Sirawit7205/dual-fan-control/dual_fan_control.kicad_pcb

## KiCad design dual_fan_control.kicad_pcb (2023-08-16)

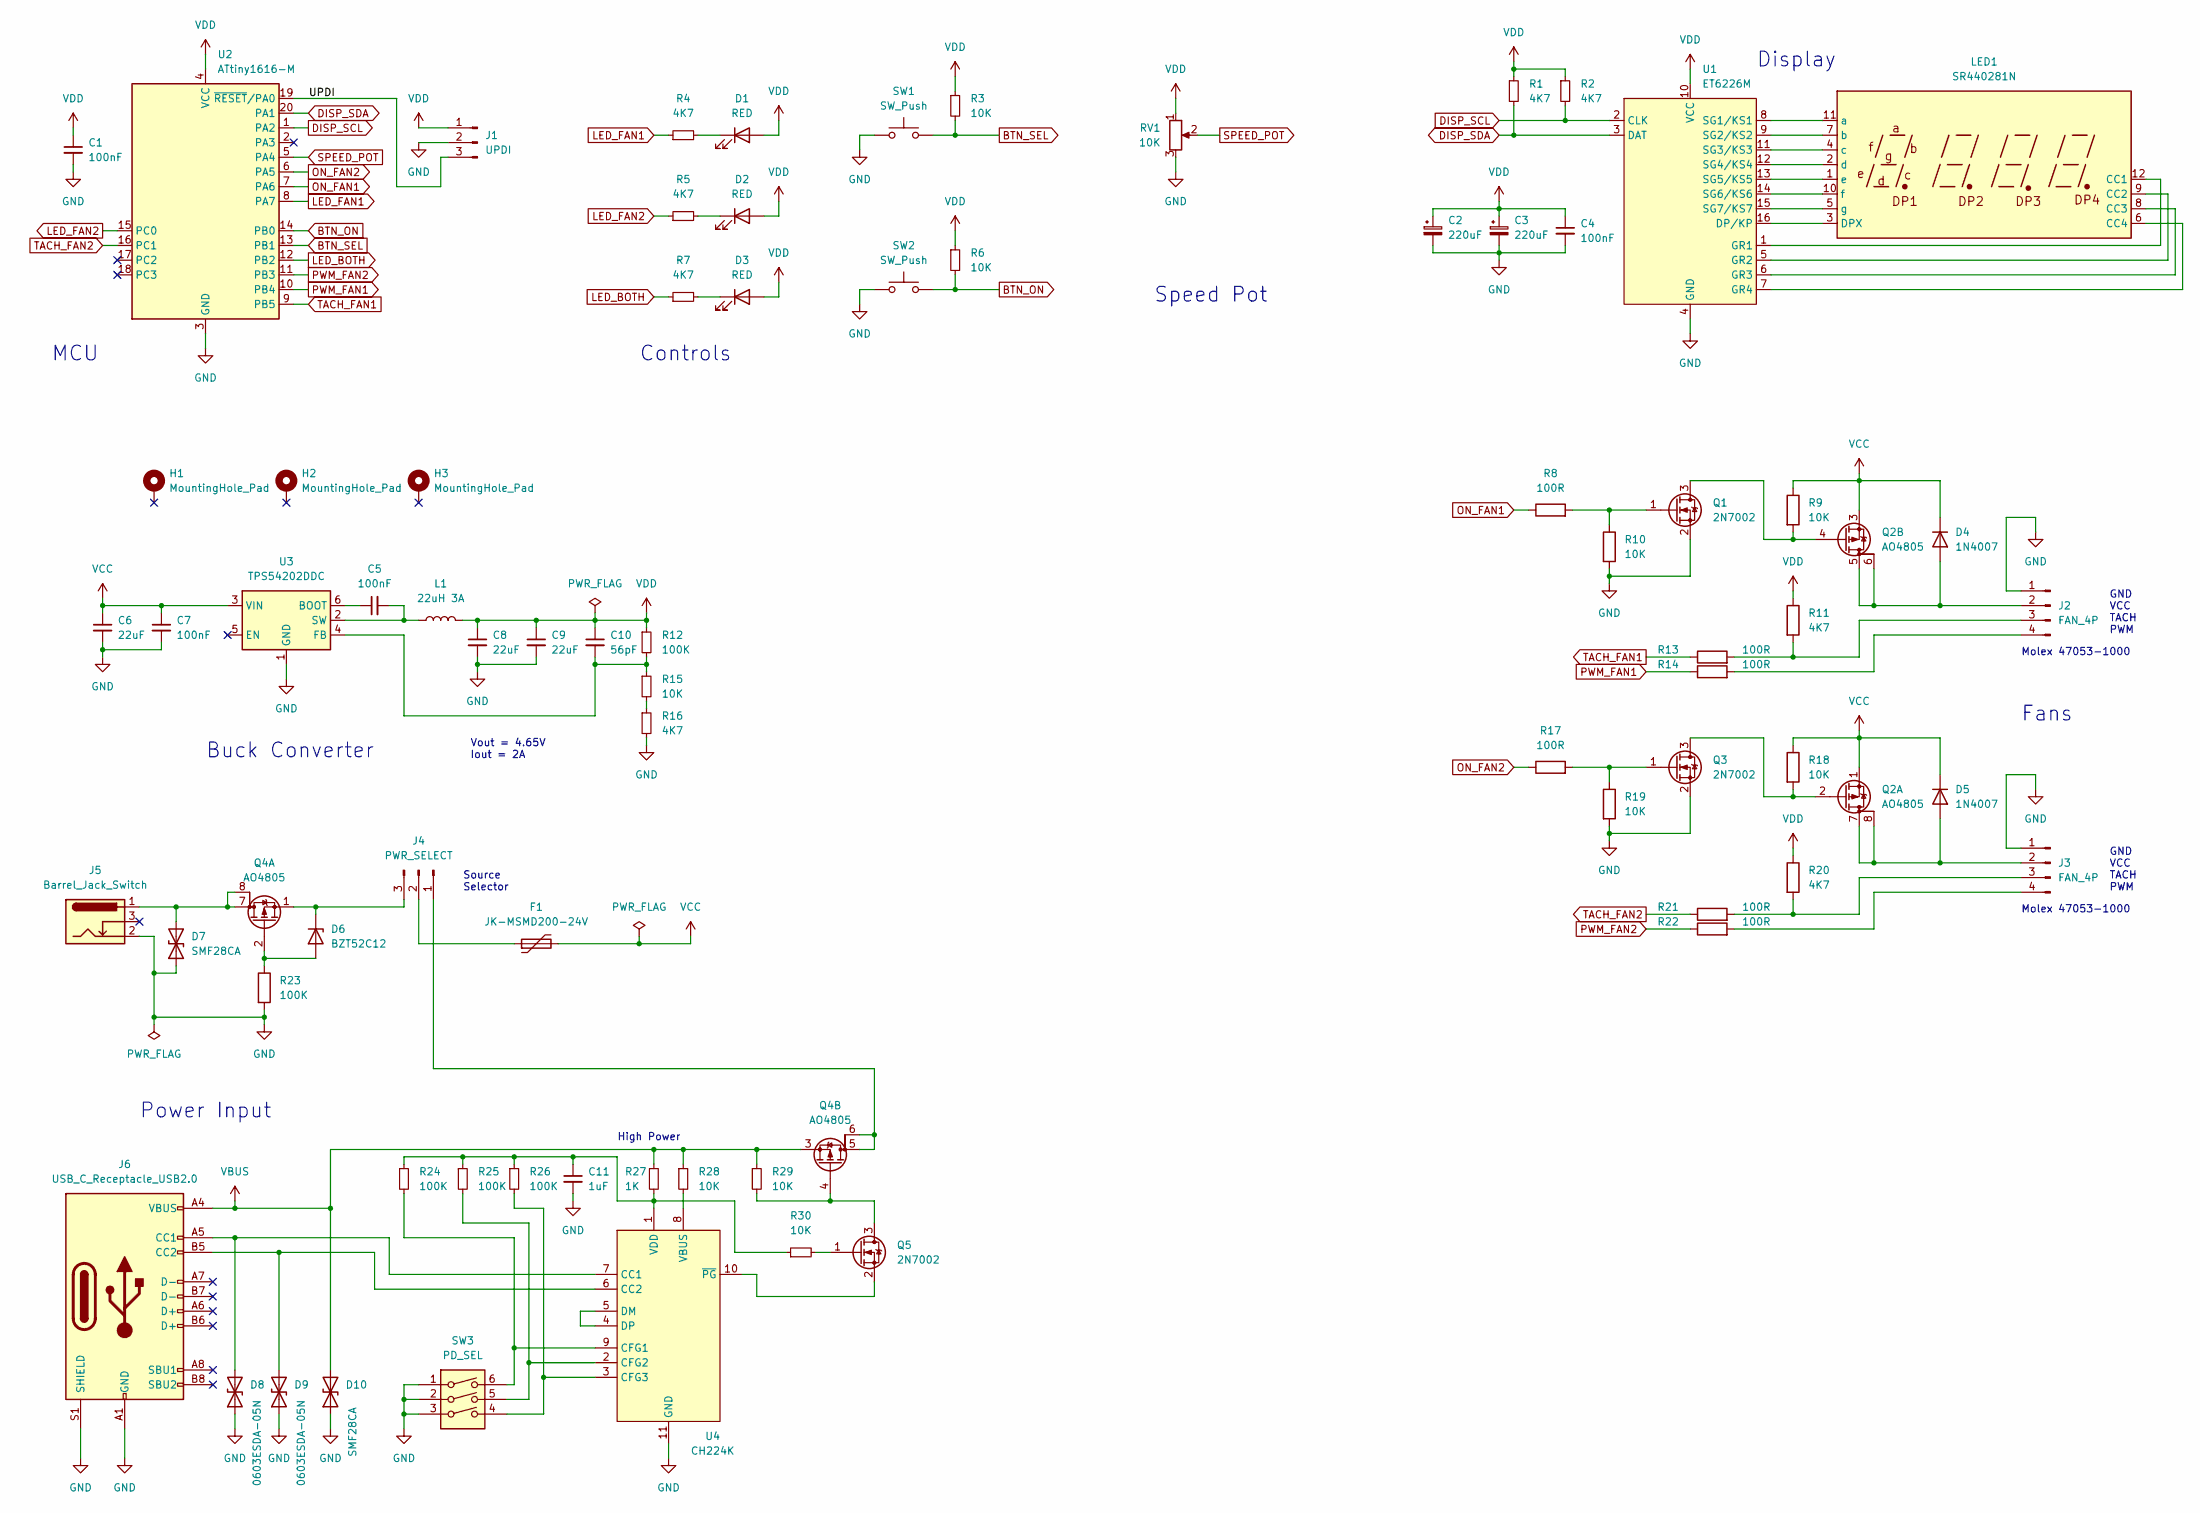
[picture p1: schematic dual_fan_control.kicad_sch, Dual PWM Fan Controller]

Parts:
C1, C4, C5, C7: 100nF; C_0603_1608Metric
C2, C3: 220uF; CP_EIA-3528-21_Kemet-B
C6, C8, C9: 22uF; C_1210_3225Metric
C10: 56pF; C_0603_1608Metric
C11: 1uF; C_0603_1608Metric
D1, D2, D3: RED; LED_0603_1608Metric
D4, D5: 1N4007; D_SOD-123F
D6: BZT52C12; D_SOD-323
D7, D10: SMF28CA; D_SOD-123F
D8, D9: 0603ESDA-05N; D_0603_1608Metric
F1: JK-MSMD200-24V; Fuse_1812_4532Metric_Pad1.30x3.40mm_HandSolder
H1, H2, H3: MountingHole_Pad; MountingHole_2.2mm_M2_DIN965_Pad
J1: UPDI; PinHeader_1x03_P2.54mm_Vertical
J2, J3: FAN_4P; Molex_KK-254_AE-6410-04A_1x04_P2.54mm_Vertical
J4: PWR_SELECT; PinHeader_1x03_P2.54mm_Vertical
J5: Barrel_Jack_Switch; BarrelJack_Horizontal_CircularHoles
J6: USB_C_Receptacle_USB2.0; USB_C_Receptacle_HRO_TYPE-C-31-M-12_NO_SBU_CircularHoles
L1: 22uH 3A; L_Bourns_SRN6045TA
LED1: SR440281N
Q1, Q3, Q5: 2N7002; SOT-23
Q2, Q4: AO4805; SOIC-8_3.9x4.9mm_P1.27mm
R1, R2, R4, R5, R7, R11, R16, R20: 4K7; R_0603_1608Metric
R3, R6, R9, R10, R15, R18, R19, R28, R29, R30: 10K; R_0603_1608Metric
R8, R13, R14, R17, R21, R22: 100R; R_0603_1608Metric
R12, R23, R24, R25, R26: 100K; R_0603_1608Metric
R27: 1K; R_1206_3216Metric
RV1: 10K; Potentiometer_Bourns_3386P_Vertical
SW1, SW2: SW_Push; SW_SPST_CK_RS282G05A3
SW3: PD_SEL; SW_DIP_SPSTx03_Slide_KingTek_DSHP03TS_W7.62mm_P1.27mm
U1: ET6226M; SOIC-16_3.9x9.9mm_P1.27mm
U2: ATtiny1616-M; VQFN-20-1EP_3x3mm_P0.4mm_EP1.7x1.7mm
U3: TPS54202DDC; SOT-23-6
U4: CH224K; ESSOP-10-1EP_3.9x4.9mm_P1.00mm_EP2.29x3mm

Connections:
/UPDI: J1.3, U2.19 (~RESET/PA0)
BTN_ON: R6.2, SW2.2, U2.14 (PB0)
BTN_SEL: R3.2, SW1.2, U2.13 (PB1)
DISP_SCL: R2.2, U1.2 (CLK), U2.1 (PA2)
DISP_SDA: R1.2, U1.3 (DAT), U2.20 (PA1)
GND: C1.2, C2.2, C3.2, C4.2, C6.2, C7.2, C8.2, C9.2, C11.2, D7.1 (A1), D8.1 (A1), D9.1 (A1), D10.1 (A1), J1.2, J2.1, J3.1, J5.2, J6.A1 (GND), J6.A12 (GND), J6.B1 (GND), J6.B12 (GND), J6.S1 (SHIELD), Q1.2 (S), Q3.2 (S), R10.2, R16.2, R19.2, R23.2, RV1.3, SW1.1, SW2.1, SW3.1, SW3.2, SW3.3, U1.4 (GND), U2.3 (GND), U2.21 (GND), U3.1 (GND), U4.11 (GND)
LED_BOTH: R7.1, U2.12 (PB2)
LED_FAN1: R4.1, U2.8 (PA7)
LED_FAN2: R5.1, U2.15 (PC0)
unnamed: C5.1, U3.6 (BOOT)
unnamed: C5.2, L1.1, U3.2 (SW)
unnamed: C10.2, R12.2, R15.1, U3.4 (FB)
unnamed: C11.1, R24.1, R25.1, R26.1, R27.2, R30.1, U4.1 (VDD)
unnamed: D1.1 (K), R4.2
unnamed: D2.1 (K), R5.2
unnamed: D3.1 (K), R7.2
unnamed: D4.2 (A), J2.2, Q2.5 (D), Q2.6 (G)
unnamed: D5.2 (A), J3.2, Q2.7 (D), Q2.8 (G)
unnamed: D6.1 (K), J4.3, Q4.1 (S)
unnamed: D6.2 (A), Q4.2 (G), R23.1
unnamed: D7.2 (A2), J5.1, Q4.7 (D), Q4.8 (G)
unnamed: D8.2 (A2), J6.A5 (CC1), U4.7 (CC1)
unnamed: D9.2 (A2), J6.B5 (CC2), U4.6 (CC2)
unnamed: F1.1, J4.2
unnamed: J2.3, R11.2, R13.2
unnamed: J2.4, R14.2
unnamed: J3.3, R20.2, R21.2
unnamed: J3.4, R22.2
unnamed: J4.1, Q4.5 (D), Q4.6 (G)
unnamed: LED1.1 (e), U1.13 (SG5/KS5)
unnamed: LED1.2 (d), U1.12 (SG4/KS4)
unnamed: LED1.3 (DPX), U1.16 (DP/KP)
unnamed: LED1.4 (c), U1.11 (SG3/KS3)
unnamed: LED1.5 (g), U1.15 (SG7/KS7)
unnamed: LED1.6 (CC4), U1.7 (GR4)
unnamed: LED1.7 (b), U1.9 (SG2/KS2)
unnamed: LED1.8 (CC3), U1.6 (GR3)
unnamed: LED1.9 (CC2), U1.5 (GR2)
unnamed: LED1.10 (f), U1.14 (SG6/KS6)
unnamed: LED1.11 (a), U1.8 (SG1/KS1)
unnamed: LED1.12 (CC1), U1.1 (GR1)
unnamed: Q1.1 (G), R8.2, R10.1
unnamed: Q1.3 (D), Q2.4 (G), R9.2
unnamed: Q2.2 (G), Q3.3 (D), R18.2
unnamed: Q3.1 (G), R17.2, R19.1
unnamed: Q4.4 (G), Q5.3 (D), R29.2
unnamed: Q5.1 (G), R30.2
unnamed: Q5.2 (S), U4.10 (~PG)
unnamed: R15.2, R16.1
unnamed: R24.2, SW3.6, U4.9 (CFG1)
unnamed: R25.2, SW3.5, U4.2 (CFG2)
unnamed: R26.2, SW3.4, U4.3 (CFG3)
unnamed: R28.2, U4.8 (VBUS)
unnamed: U4.4 (DP), U4.5 (DM)
ON_FAN1: R8.1, U2.7 (PA6)
ON_FAN2: R17.1, U2.6 (PA5)
PWM_FAN1: R14.1, U2.10 (PB4)
PWM_FAN2: R22.1, U2.11 (PB3)
SPEED_POT: RV1.2, U2.5 (PA4)
TACH_FAN1: R13.1, U2.9 (PB5)
TACH_FAN2: R21.1, U2.16 (PC1)
VBUS: D10.2 (A2), J6.A4 (VBUS), J6.A9 (VBUS), J6.B4 (VBUS), J6.B9 (VBUS), Q4.3 (S), R27.1, R28.1, R29.1
VCC: C6.1, C7.1, D4.1 (K), D5.1 (K), F1.2, Q2.1 (S), Q2.3 (S), R9.1, R18.1, U3.3 (VIN)
VDD: C1.1, C2.1, C3.1, C4.1, C8.1, C9.1, C10.1, D1.2 (A), D2.2 (A), D3.2 (A), J1.1, L1.2, R1.1, R2.1, R3.1, R6.1, R11.1, R12.1, R20.1, RV1.1, U1.10 (VCC), U2.4 (VCC)

Notes on the sheet:
Fans
Molex 47053-1000
GND VCC TACH PWM
High Power
MCU
Vout = 4.65V Iout = 2A
Display
Source Selector
Buck Converter
Controls
Speed Pot
Power Input

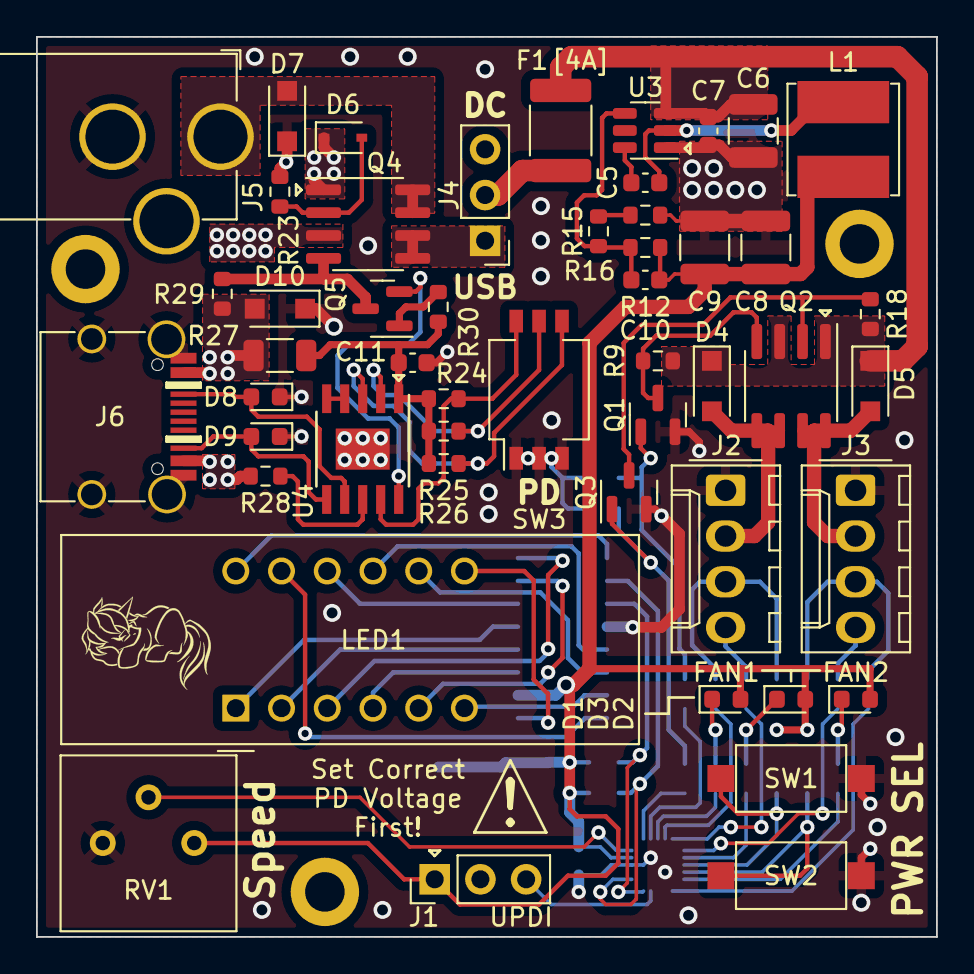
[picture p2: board dual_fan_control.kicad_pcb from above]

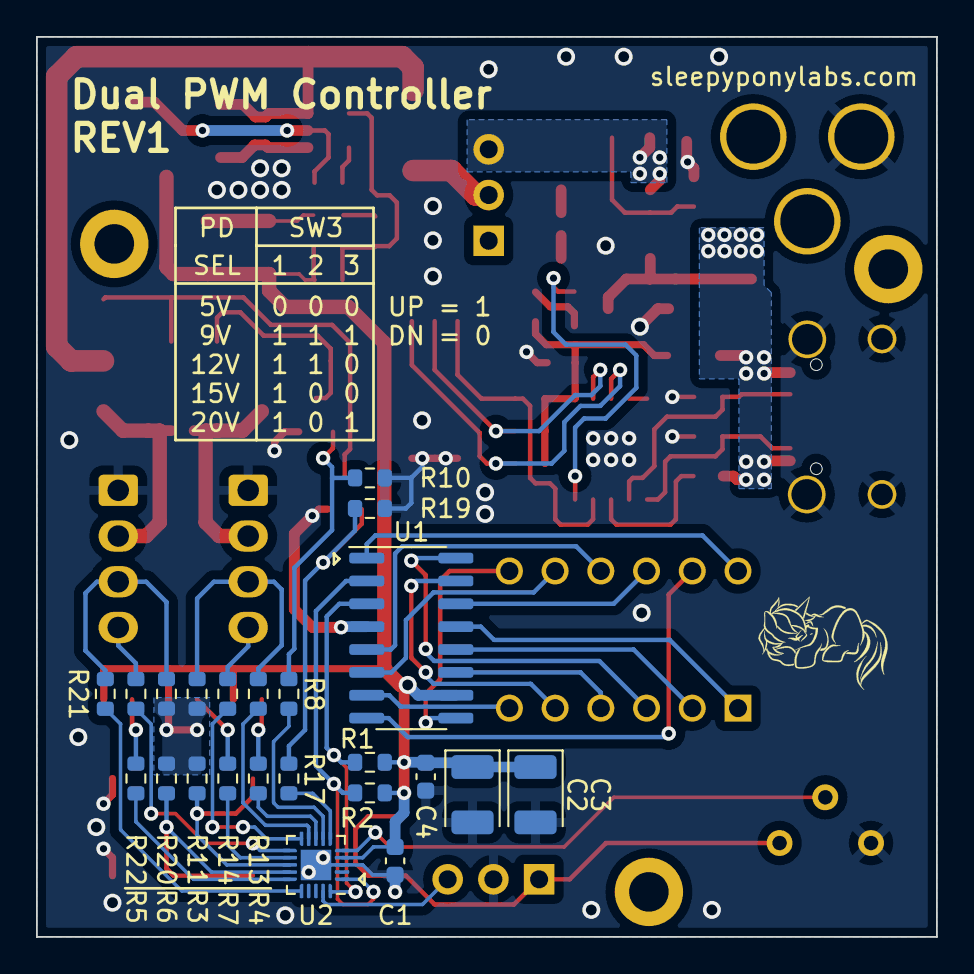
[picture p3: board dual_fan_control.kicad_pcb from below]

Board: 2 copper layers, 50.0 x 50.0 mm, 76 parts (23 on the bottom side), 64 nets.
