Sirawit7205/dual-fan-control/(commit log)

2023-05-20 Minor adjustments
    [dual_fan_control.kicad_pcb, dual_fan_control.kicad_sch]
2023-05-21 Add IBOM
    [dual_fan_control.kicad_pcb]
2023-06-11 Update IBOM
    [dual_fan_control.kicad_pcb, dual_fan_control.kicad_sch]
2023-08-16 Fix incorrect button net labels
    [dual_fan_control.kicad_pcb, dual_fan_control.kicad_sch]
2023-08-26 Fix tach speed measurement
    [main.c, millis.c, speed_measurement.c, speed_measurement.h]
2023-09-02 add scienfic notation output for fan speed over 9999 RPM
2023-09-13 Add power % display and fixed PWM timer not running
    [display.c, display.h, main.c, user_interface.c, user_interface.h]
